emlyon/makers-furniture/readme.md

# makers furniture

open source furniture that can be made locally using digital fabrication.
