emlyon/makers-furniture/(list of files, cad)

Other CAD files:
minima_cafe_table/cnc_sample.3dm
minimacafé/minima café_21mm.3dm
