emlyon/makers-furniture/AIpod/AIpod_chair_assembly.pdf

### OUTER SHELL ASSEMBLY

Parts required :
- 1x SA : left seat front panel
- 1x SB : right seat front panel
- 1x SC : main seat frame
- 1x SD : front seat pad riser
- 1x SE : back seat pad riser
- 1x SF : seat panel
- 1x SG : speakers holder
- 1x SH : seat backrest
- 13x 6mm x 60mm wood screws
- Wood glue
- 4x speakers visaton FRS-8
or other 80mm diam. speakers Tools required :
- 4mm wood drill for predrilling
- mallet
- cordless drill

Parts required :
- 3x OA : upwards large triangle
- 3x OB : downwards small triangle
- 6x OC : small upper connector
- 4x OD : large lower connector
- 2x OE : downwards large triangle
- 2x OF : upwards small triangle
- 4x OG : long vertical outwards connector
- 2x OH : backrest connector
- 2x OI : long vertical inwards connector
- 1x OJ : upper right end panel
- 1x OK : upper left end panel
- 1x OL : lower right end triangle
- 1x OM : lower left end triangle
- 1x AA : left armrest top part
- 2x AB : armrests vertical part
- 1x AC : right armrest top part
- 96x 6mm x 60mm wood screws Tools required :
- 4mm wood drill for predrilling
- mallet
- cordless drill
5. Left armrest : screw the top AA part to the AB vertical part,
then screw the LCD screen on the top AA armrest part.
Right armrest : screw the AC top part to the
AB vertical part. Mount the to armrests and install the seating pads
3. Screw OA and OB (triangles) to OI (long connector). Then screw 1 OC connector on the OA part
(large triangle) and 1 OD connector on the OB
part (small triangle).
4. End right side : screw OJ and OL parts to 1 OG part (long connector).
End left side screw OK and OM parts to 1 OG part (long connector).
Then screw each side to the OC and OD connector and the SA and SB parts.

OE

1. screw OA and OB (triangles) to SC parts. Then screw 2 OC connectors on the OA part (large triangle) and 2 OD connectors on the OB part (small triangle).
2. screw OE and OF (triangles) to OG (long connector).
Then screw 1 OC connectors on the OE part (large triangle) and 1 OH connectors on the OF (small triangle) and SH part. Repeat for the other side of the shell

OB

OC OC

OD | OD

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
1. screw SF part on SA, SB and SC parts.
Then screw or glue SD and SE parts on top of SF part.

SC
SB
SA

finished seat assermbly

SG

SH

2. Mount the 4 speakers on SG part.
Then screw the SG and SH parts to SC part

### SEAT ASSEMBLY

### AIpod CHAIR - ASSEMBLY GUIDE

### 2019 - emlyon Business School Makers’ Lab - Théophile Thomas

### AIpod CHAIR - PARTS LIST

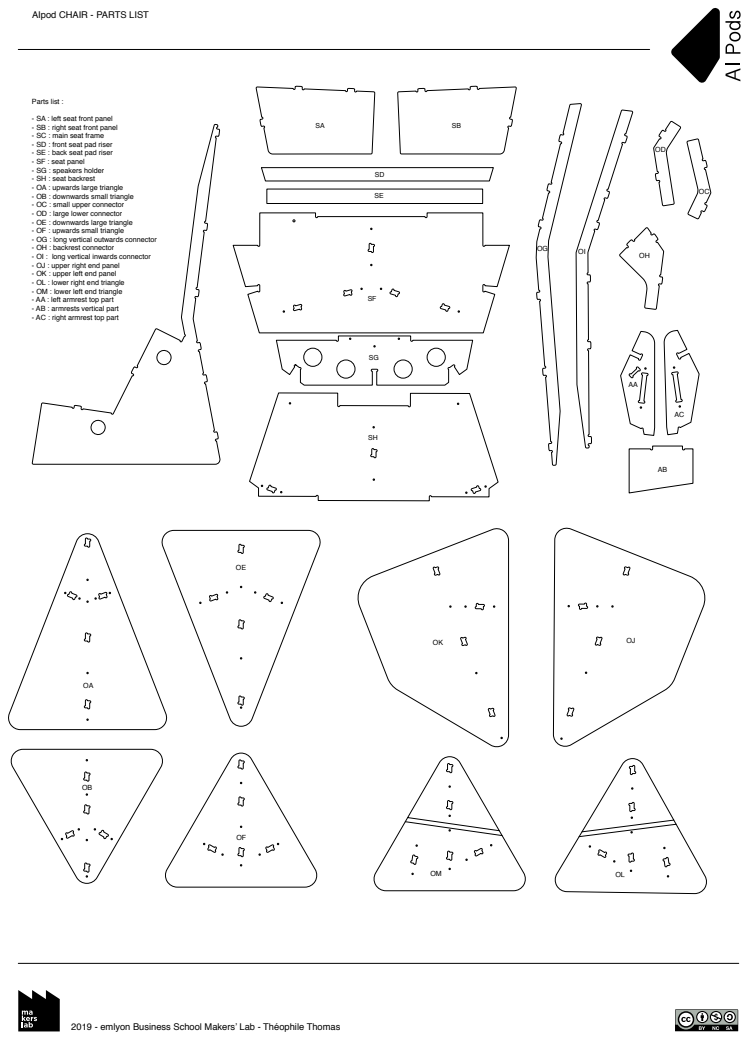
[picture p8: page 2]

Parts list :
- SA : left seat front panel
- SB : right seat front panel
- SC : main seat frame
- SD : front seat pad riser
- SE : back seat pad riser
- SF : seat panel
- SG : speakers holder
- SH : seat backrest
- OA : upwards large triangle
- OB : downwards small triangle
- OC : small upper connector
- OD : large lower connector
- OE : downwards large triangle
- OF : upwards small triangle
- OG : long vertical outwards connector
- OH : backrest connector
- OI : long vertical inwards connector
- OJ : upper right end panel
- OK : upper left end panel
- OL : lower right end triangle
- OM : lower left end triangle
- AA : left armrest top part
- AB : armrests vertical part
- AC : right armrest top part

2019 - emlyon Business School Makers’ Lab - Théophile Thomas
