emlyon/makers-furniture/(commit log)

2019-03-13 minima café update
    [breakoutTable_opendesk.3dm, minima café_21mm.3dm]
2019-03-13 add AIpod and images
    [cnc_sample.3dm]
