emlyon/makers-furniture/(notices)

Notices in the files:
AIpod/readme.md:
license creative commons by-nc-sa 4.0
